deonvdw/heatpump/Interface/20191230_143704.jpg

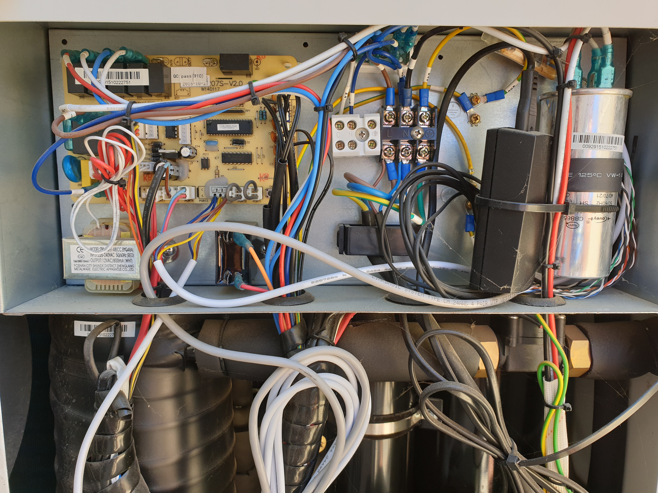
Interface/20191230_143704.jpg
