deonvdw/heatpump/Interface/20180908_171105.jpg

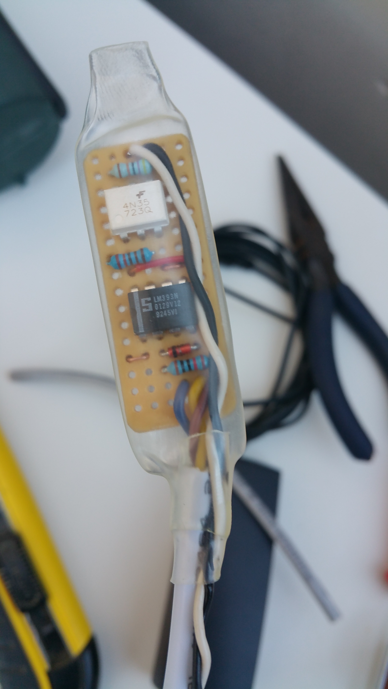
Interface/20180908_171105.jpg
