deonvdw/heatpump/README.md

# heatpump
MQTT interface to SunWorx Heat Pump
