deonvdw/heatpump/Interface/20180908_142629.jpg

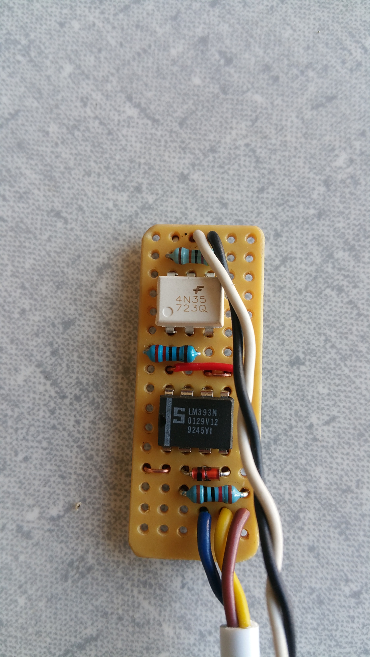
Interface/20180908_142629.jpg
