deonvdw/heatpump/Interface/20180908_142647.jpg

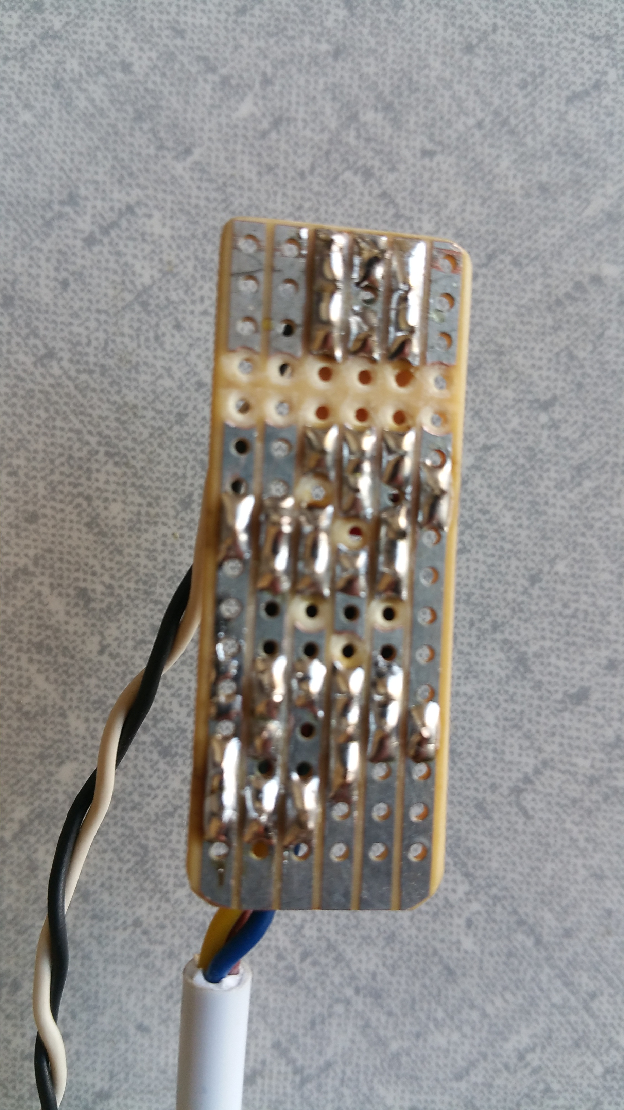
Interface/20180908_142647.jpg
