deonvdw/heatpump/Protocol/HeatpumpAndKeypadMsg.bmp

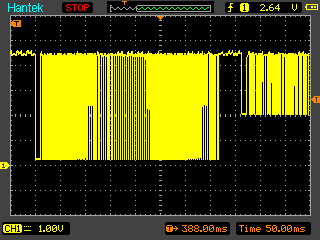
Protocol/HeatpumpAndKeypadMsg.bmp
