deonvdw/heatpump/Protocol/HeatpumpMsgBitsDetail.bmp

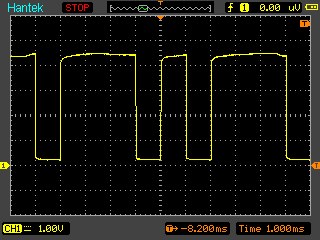
Protocol/HeatpumpMsgBitsDetail.bmp
