deonvdw/heatpump/Protocol/HeatpumpMsgStart.bmp

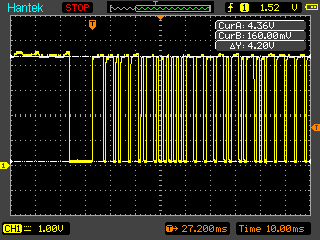
Protocol/HeatpumpMsgStart.bmp
