deonvdw/heatpump/Protocol/HeatpumpMsgStartNoCursor.bmp

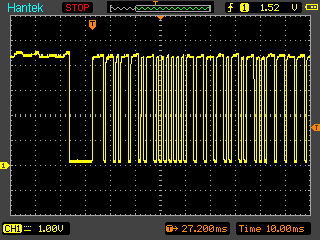
Protocol/HeatpumpMsgStartNoCursor.bmp
