deonvdw/heatpump/Protocol/KeypadBitDetail.bmp

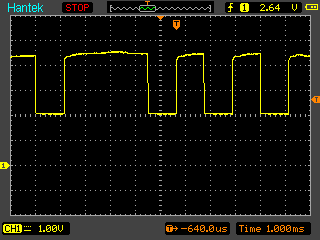
Protocol/KeypadBitDetail.bmp
