deonvdw/heatpump/Protocol/KeypadMessage.bmp

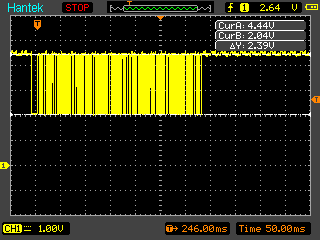
Protocol/KeypadMessage.bmp
