deonvdw/heatpump/Protocol/KeypadMessageNoCursor.bmp

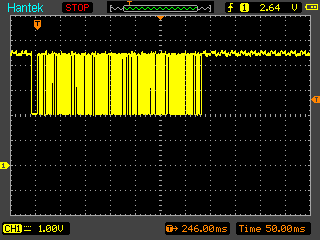
Protocol/KeypadMessageNoCursor.bmp
