deonvdw/heatpump/Protocol/KeypadMessageStart.bmp

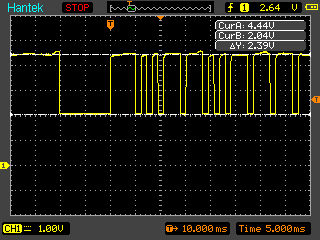
Protocol/KeypadMessageStart.bmp
