deonvdw/heatpump/(threads)

Thread 1 (2024-08-23):

Updating Heat Pump Settings

zizebra, 2024-08-23:
Hey Man,

I stumbled on your work here and loved it. Thank you . I just wanted to check if you are still actively working on this.

deonvdw, 2024-08-26:
Hi zizebra

Thank you for the kind words. The heat pump interface is pretty much complete for my needs so there is no active work being done on it. Are there any particular features you feel this is missing?

zizebra, 2024-08-26:
Yes I just wanted to check on two things,
1. the connection you made, did you use RS485 adapter or did you just use plain level shifter from 3.3v to 5v
2. Is there any plan to control the heatpump.
Iam working adapting this to my ITS heat pump which also feature same keypad with 3 wires instead of 4.

deonvdw, 2024-08-26:
> Yes I just wanted to check on two things,
>
> 1. the connection you made, did you use RS485 adapter or did you just use plain level shifter from 3.3v to 5v

I chose a more cautious approach: I used a comparator (LM393) to check the voltage on the signal line against a reference voltage. The LM393 then drives an opto-isolator (4N36), which then drives the ESP32. Maybe a bit overkill - but I wanted a totally isolated output to leave the heat pump

> 2. Is there any plan to control the heatpump.
>    Iam working adapting this to my ITS heat pump which also feature same keypad with 3 wires instead of 4.

There was a plan, but my heat pump recently suffered mechanical failure, so I will be replacing it. Never got around to building the "send" part of the interface - would be an opto-coupler (again) driving a 2N7000 FET to pull the data line low, probably through a low value resistor. Still wanted to measure what value resistor to use...

As a side note - my controller PCB is marked as being a CC207S - V2.0 with firmware FSB20045.HEX - if that helps you determine how closely it matches your ITS. ITS might very well be using the same building blocks.

zizebra, 2024-08-27:
thank you. My pcb is different CC395 V3.1. But i think the general logic should be the same. I will find out soon enough.

zizebra, 2024-08-27:
thank you. I just noted the images you posted.

zizebra, 2024-08-31:
I succeeded in connecting with level shifter. I do see failures. The most common one being init too short. I have ordered a logic analyzer to try and understand.  Through the work of Nic on a different HP, he created script to report changes in signal with time frames. This has led to identify that my bit stream is almost similar to yours. I do see the 9ms followed by 4.5ms  on the start of message. I also see the termination which double yours. The logic seems opposite to yours where 9ms is high instead of low and 4ms is low instead of high. Your code stumped me on how to update it to match this. But iam sure I will get to figure it out sooner or later

zizebra, 2024-09-04:
 I have now managed to read the values. They are similar indeed Published every 3ms, 1 Message with measured values and another with configured parameters.
The next portion has had my head spinning, the one for key pad messages. I have not been able to make head or tail about it. The script used previously shows that the pulses when keypad is pressed are all 1s and pulse time varying between 15 and 30 microseconds.. Makes me think that it is the same as your too.
Yahoo Mail: Search, organise, conquer

  On Mon, 26 Aug 2024 at 18:39, ***@***.***> wrote:

Yes I just wanted to check on two things,

   - the connection you made, did you use RS485 adapter or did you just use plain level shifter from 3.3v to 5v

I chose a more cautious approach: I used a comparator (LM393) to check the voltage on the signal line against a reference voltage. The LM393 then drives an opto-isolator (4N36), which then drives the ESP32. Maybe a bit overkill - but I wanted a totally isolated output to leave the heat pump

   - Is there any plan to control the heatpump.
Iam working adapting this to my ITS heat pump which also feature same keypad with 3 wires instead of 4.

There was a plan, but my heat pump recently suffered mechanical failure, so I will be replacing it. Never got around to building the "send" part of the interface - would be an opto-coupler (again) driving a 2N7000 FET to pull the data line low, probably through a low value resistor. Still wanted to measure what value resistor to use...

As a side note - my controller PCB is marked as being a CC207S - V2.0 with firmware FSB20045.HEX - if that helps you determine how closely it matches your ITS. ITS might very well be using the same building blocks.

—
Reply to this email directly, view it on GitHub, or unsubscribe.
You are receiving this because you authored the thread.Message ID: ***@***.***>
