deonvdw/heatpump/(commit log)

2019-12-31 Create Heat pump protocol.txt
2024-08-26 Heat pump monitor interface
    Interface circuit board layout and photos
